SnehasisBhowmick/UTM-mini/README.md

# DOCUMENTATION

This folder contains all the required files for our UTM machine

By - SNEHASIS BHOWMICK (MS IIT KHARAGPUR), PAMURU CHARAN(3rd year NIT RAIPUR)

Guided by - Dr. Ashutosh Tiwari, Centre Of Excellence in Affordable Healthcare IIT Kharagpur
