SnehasisBhowmick/UTM-mini/(commit log)

2025-06-28 Ad sensor datas
    [sensor1_1000.csv, sensor1_2000.csv, sensor1_3000.csv, sensor1_4000.csv, sensor1_5000.csv]
2025-06-28 inital file for arduino
